RaspPiGuy/-Weather-Displayed-On-LED-Display---ATmega-and-ESP12-Project/Videos and Photos For Youtube Video/Resize of Page2.jpg

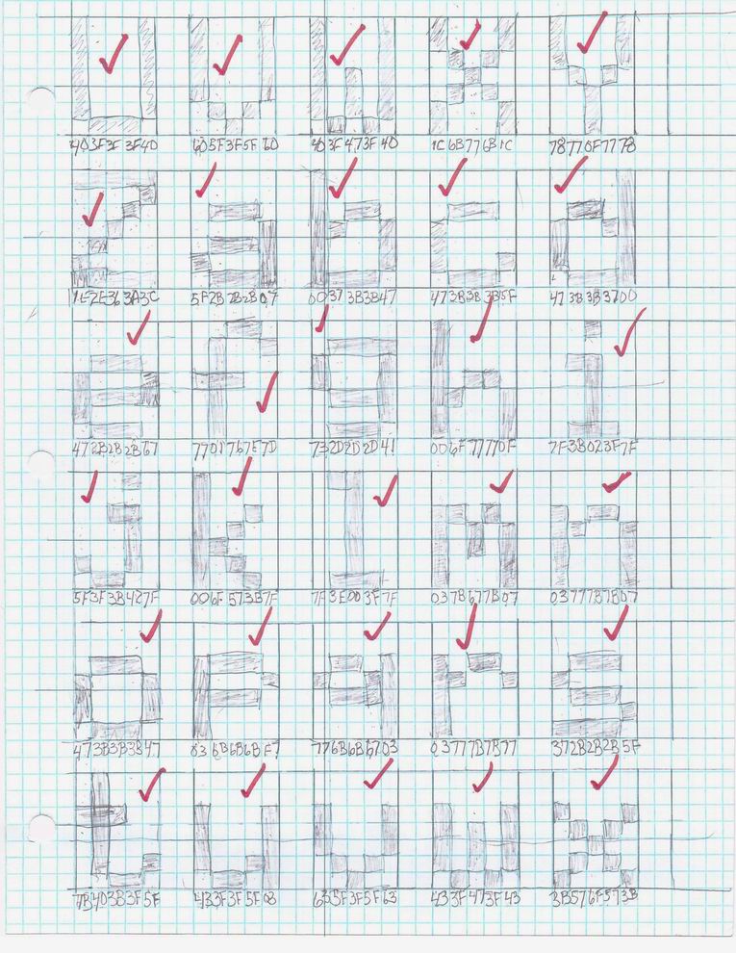
Videos and Photos For Youtube Video/Resize of Page2.jpg
