RaspPiGuy/-Weather-Displayed-On-LED-Display---ATmega-and-ESP12-Project/Videos and Photos For Youtube Video/IMG_2549.JPG

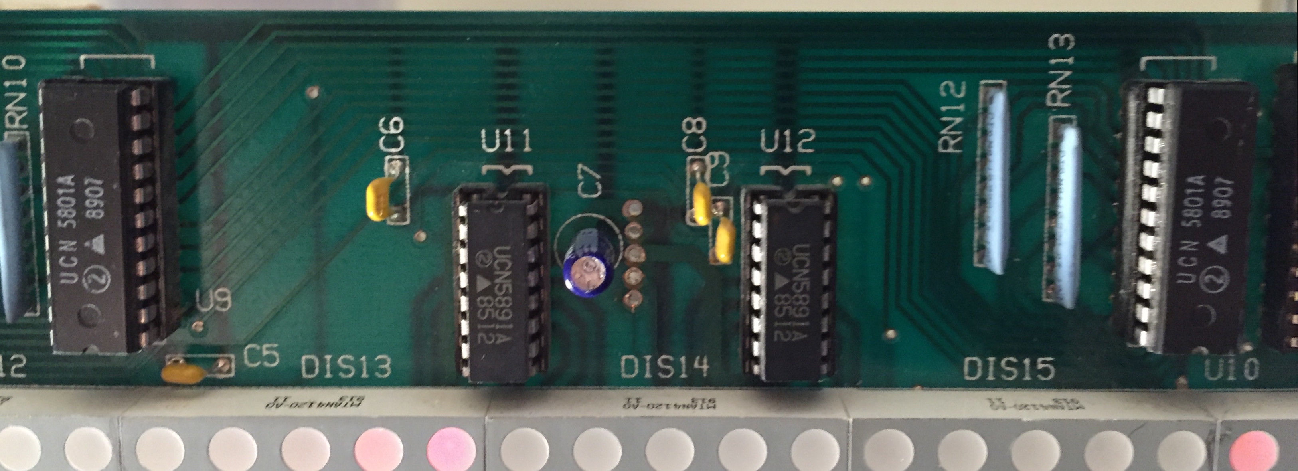
Videos and Photos For Youtube Video/IMG_2549.JPG
