RaspPiGuy/-Weather-Displayed-On-LED-Display---ATmega-and-ESP12-Project/Videos and Photos For Youtube Video/IMG_2537.JPG

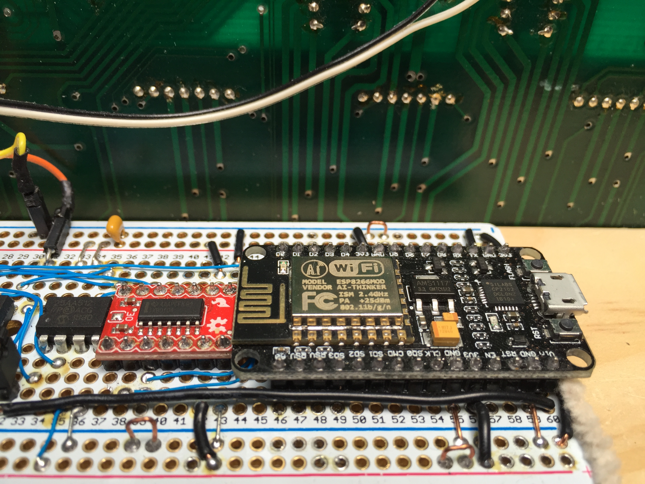
Videos and Photos For Youtube Video/IMG_2537.JPG
