RaspPiGuy/-Weather-Displayed-On-LED-Display---ATmega-and-ESP12-Project/Videos and Photos For Youtube Video/IMG_2538.JPG

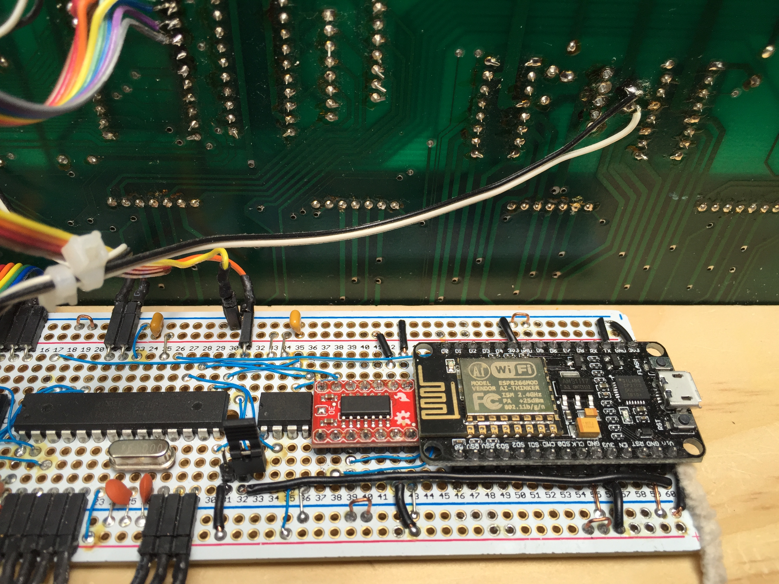
Videos and Photos For Youtube Video/IMG_2538.JPG
