RaspPiGuy/-Weather-Displayed-On-LED-Display---ATmega-and-ESP12-Project/Videos and Photos For Youtube Video/LED Display Module.jpg

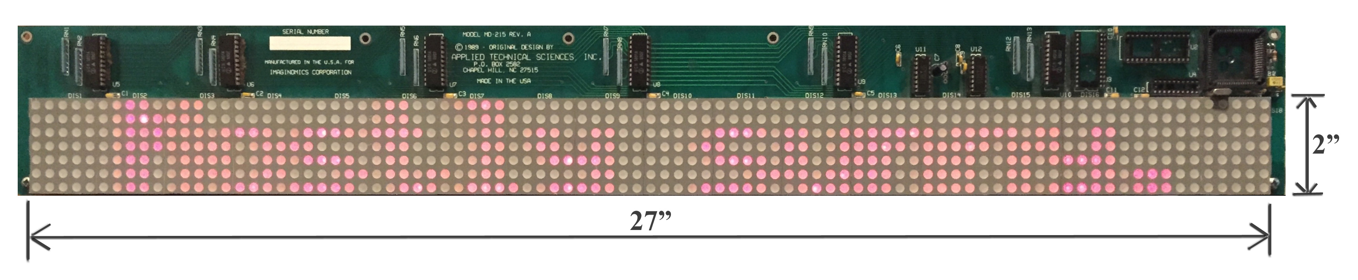
Videos and Photos For Youtube Video/LED Display Module.jpg
