RaspPiGuy/-Weather-Displayed-On-LED-Display---ATmega-and-ESP12-Project/Videos and Photos For Youtube Video/Rotation of IMG_2512.JPG

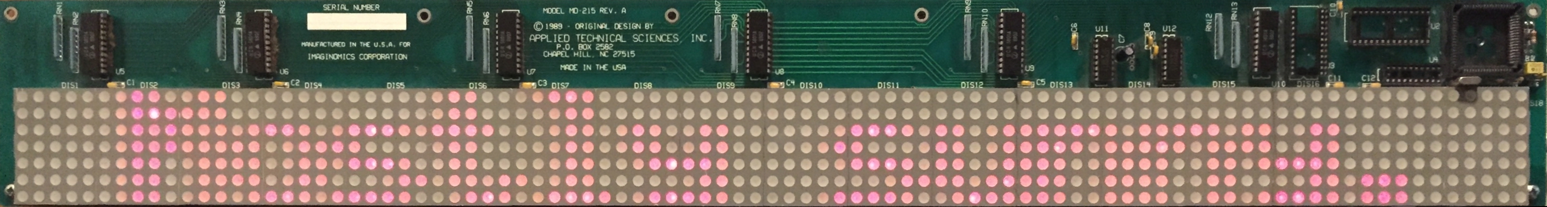
Videos and Photos For Youtube Video/Rotation of IMG_2512.JPG
