RaspPiGuy/-Weather-Displayed-On-LED-Display---ATmega-and-ESP12-Project/Display Board Schematics/Large18CharacterDisplay_Page1.pdf

33uF 16V | Strobe_2 Strobe_3

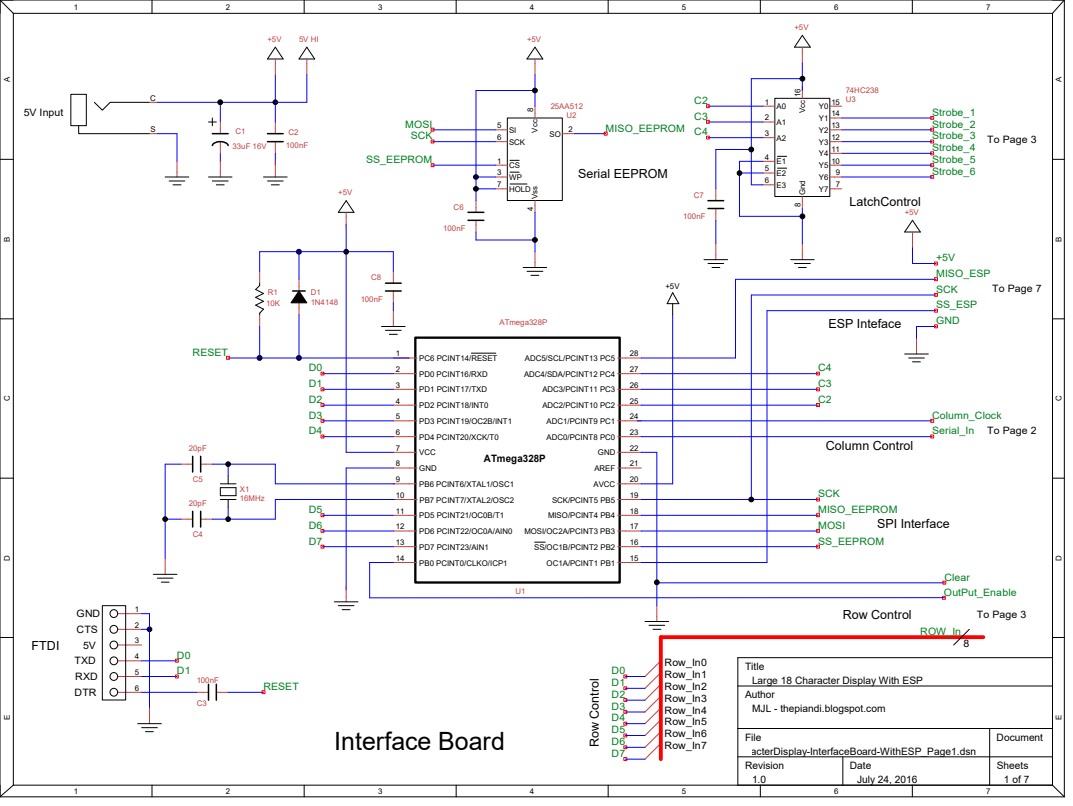
[picture p10: page 1]

Title
Large 18 Character Display With ESP
Author
MJL - thepiandi.blogspot.com

File | Document
Revision 1.0 | Date July 24, 2016 | Sheets 1 of 7
