RaspPiGuy/-Weather-Displayed-On-LED-Display---ATmega-and-ESP12-Project/Display Board Schematics/Large18CharacterDisplay_Page2.pdf

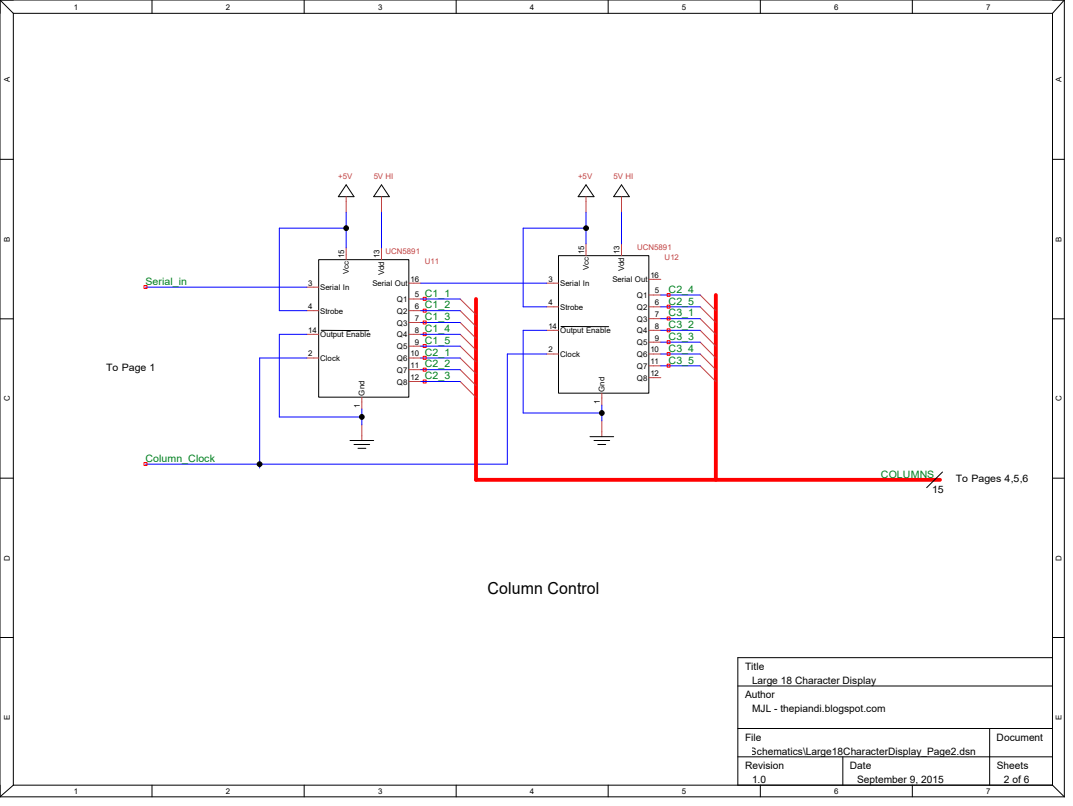
[picture p11: page 1]

Serial Out 16 Vdd 13 Gnd
Serial In 3
Strobe 4
Output Enable 14
Clock 2

Title
Large 18 Character Display
Author
MJL - thepiandi.blogspot.com

File | Document
Revision 1.0 | Date September 9, 2015 | Sheets 2 of 6
