RaspPiGuy/-Weather-Displayed-On-LED-Display---ATmega-and-ESP12-Project/Display Board Schematics/Large18CharacterDisplay_Page3.pdf

Clear 1 | Vdd 21 Gnd 11 | Common 12
Clear 1 | Vdd 21 Gnd 11 | Common 12

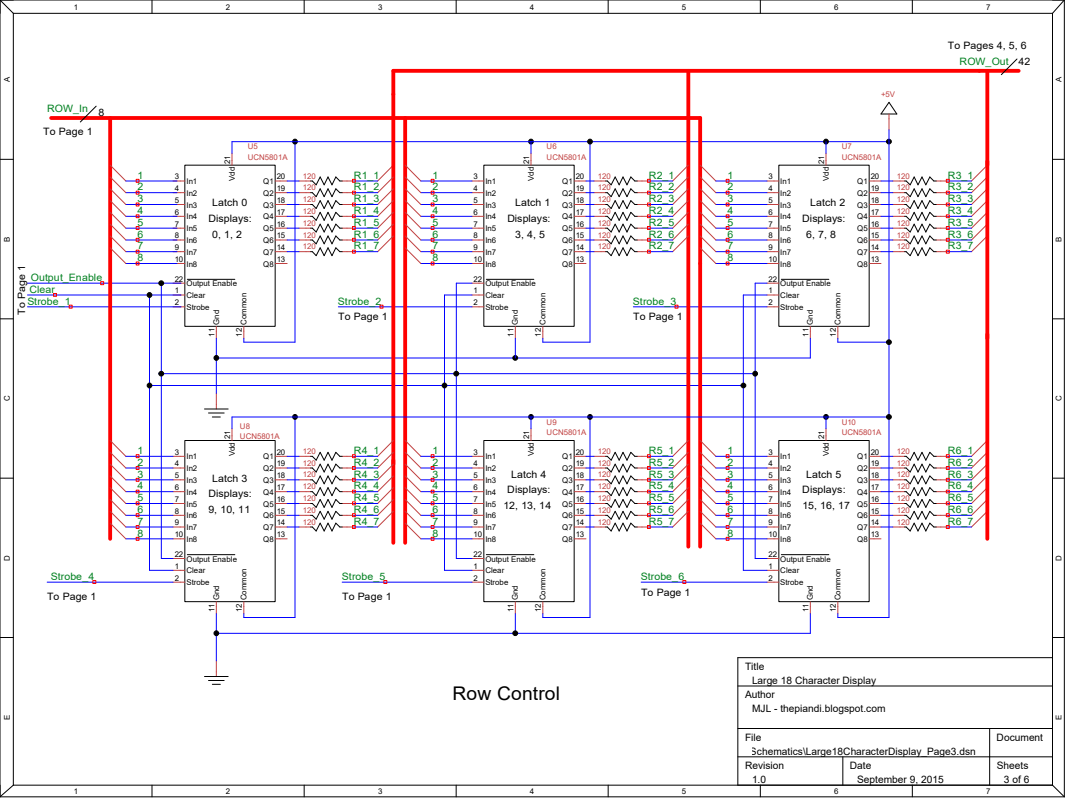
[picture p12: page 1]

To Page 1

Title
Large 18 Character Display
Author
MJL - thepiandi.blogspot.com

File | Document
Revision 1.0 | Date September 9, 2015 | Sheets 3 of 6
