RaspPiGuy/-Weather-Displayed-On-LED-Display---ATmega-and-ESP12-Project/Display Board Schematics/Large18CharacterDisplay_Page7.pdf

# GPIO16 30 ESP¹²E Develomnent Module

### ESP12E Development Module can be powered from the USB Connector

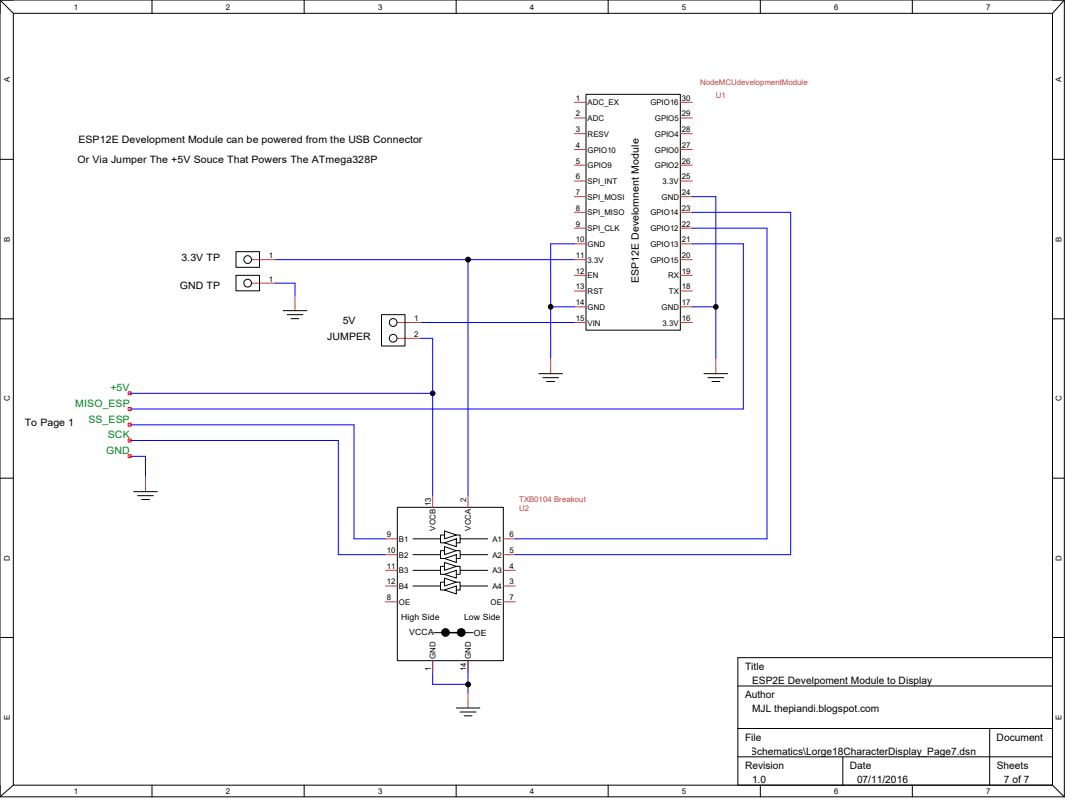
[picture p13: page 1]
1 3.3V TP 1 GND TP; MISO_ESP SS_ESP SCK; To Page 1; GND; 1 VCCB 13; A4 3 VCCA; 2 GND 14; High Side; Low Side; VCCA; TXB0104 Breakout GND; ADC_EX 1 ADC 2 RESV 3 GPIO10 4 GPIO9 5 SPI_INT 6 SPI_MOSI 7 SPI_MISO 8 SPI_CLK 9 GND 10 3.3V 11 EN 12 RST 13 GND 14; VIN 15; GND 17; GPIO15 20; GPIO13 21; GPIO12 22; GPIO14 23; GND 24; GPIO2 26; GPIO0 27; GPIO4 28; GPIO5 29; NodeMCUdevelopmentModule; 1 2 JUMPER

Or Via Jumper The +5V Souce That Powers The ATmega328P

Title
ESP2E Develpoment Module to Display
Author
MJL thepiandi.blogspot.com

File | Document
Revision 1.0 | Date 07/11/2016 | Sheets 7 of 7
