RaspPiGuy/-Weather-Displayed-On-LED-Display---ATmega-and-ESP12-Project/Display Board Layout/DisplayBoardWithESP2EdevelopmentModlayout.pdf

# 100n ¹⁰⁰n

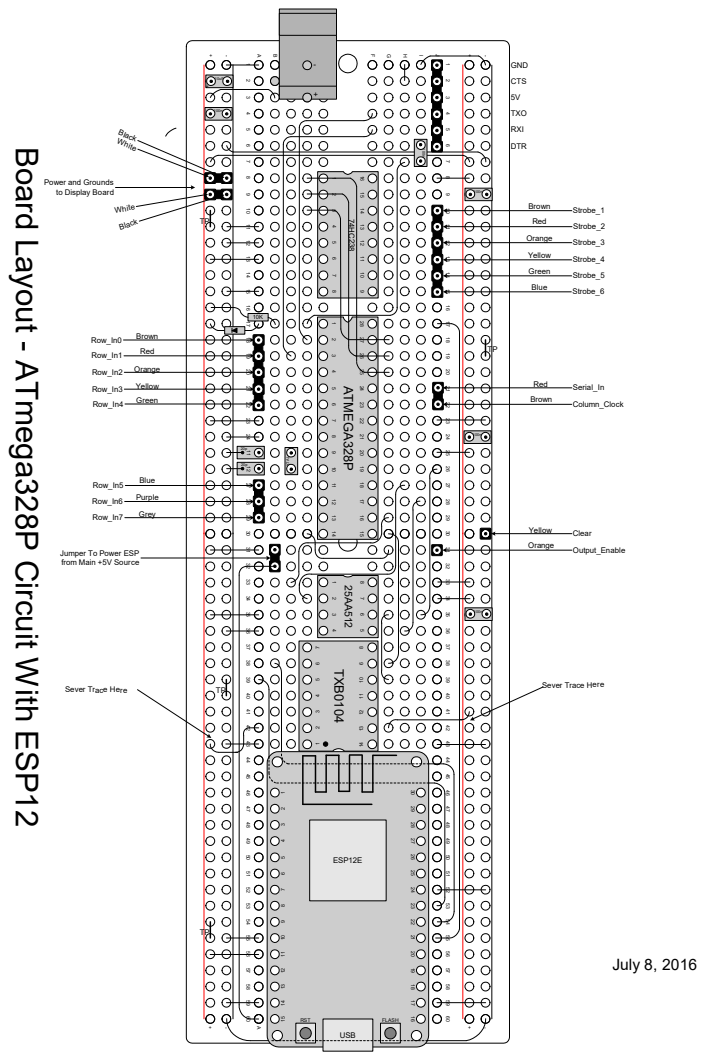
[picture p14: page 1]
IJ - 30 31 32 33 34 35 36 37 38 39 40 41 42 43 44 45 46 47 48 49 50 51 52 53 54 55 56 57 58 30 31 32 33 34 35 36 37 38 39 40 41 42 43 44 45 46 47 48 49 50 51 52 53 54 55 56 57 58 5959 ATMEGA328P; XTAL; Row_In0 Row_In1 Row_In2 Row_In3 Row_In4; Row_In5 Row_In6 Row_In7; Clear Output_Enable; Column_Clock; Serial_In 25AA512; Strobe_1 Strobe_2 Strobe_3 Strobe_4 Strobe_5 Strobe_6; July 8, 2016; Black; Brown Red Orange Yellow Green; Blue Purple Grey; Yellow Orange; Red Brown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

to Display Board White WhiteBlack

Board Layout - ATmega328P Circuit With ESP12
Power and Grounds

Jumper To Power ESP
from Main +5V Source
