RaspPiGuy/-Weather-Displayed-On-LED-Display---ATmega-and-ESP12-Project/Display Board Schematics/Large18CharacterDisplay_Page5.pdf

R3_1
R3_2

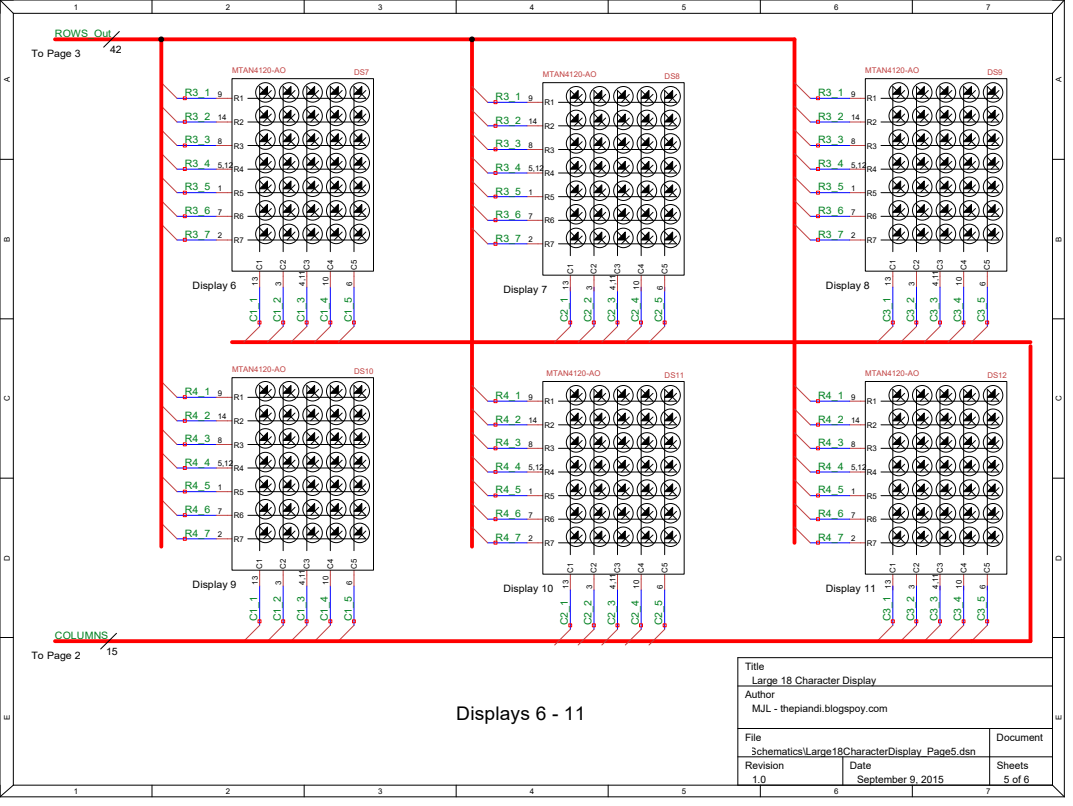
[picture p15: page 1]

Title
Large 18 Character Display
Author
MJL - thepiandi.blogspoy.com

File | Document
Revision 1.0 | Date September 9, 2015 | Sheets 5 of 6
