RaspPiGuy/-Weather-Displayed-On-LED-Display---ATmega-and-ESP12-Project/(list of files, drawings)

Other design files:
Display Board Schematics/Large18CharacterDisplay_Page1.dsn
Display Board Schematics/Large18CharacterDisplay_Page2.dsn
Display Board Schematics/Large18CharacterDisplay_Page3.dsn
Display Board Schematics/Large18CharacterDisplay_Page4.dsn
Display Board Schematics/Large18CharacterDisplay_Page5.dsn
Display Board Schematics/Large18CharacterDisplay_Page6.dsn
Display Board Schematics/Lorge18CharacterDisplay_Page7.dsn
