RaspPiGuy/-Weather-Displayed-On-LED-Display---ATmega-and-ESP12-Project/(commit log)

2016-08-02 Replaced IP address with host name
    [ESP_toATmega_ForDisplay_V1R3.ino]
2016-08-08 New Version of ESP to ATmega Prevents ESP from hanging if ATmega doesn't respond
    [ESP_toATmega_ForDisplay_V1R5.ino]
2016-08-17 Combined 2 ATmega Files Into 1. Added heat index
2016-09-07 Feels Like Temp will not display if it equals current temperature.
2017-04-27 Corrected Problem Where All 8 Forecasts Were Identical. Rainfall only displays if rainfall over 0.00 in.
    [ESP_toATmega_ForDisplay_V1R8.ino, TimesSquareScroll_WeatherFromESP_V1R4.ino]
